AhmedMKAlzoubi/Graduation-Project-Public/Hardware/Components/PB0A/images.jpeg

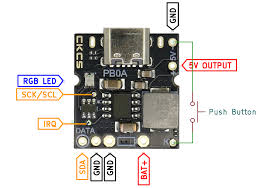
Hardware/Components/PB0A/images.jpeg
