AhmedMKAlzoubi/Graduation-Project-Public/Hardware/Components/PB0A/shopify_pics_23.webp

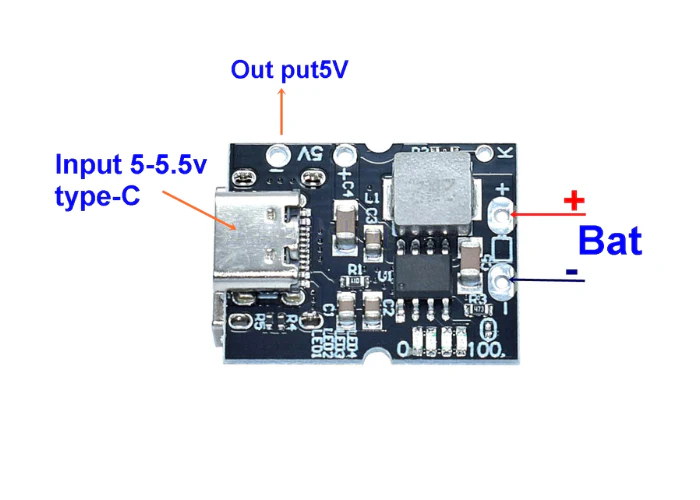
Hardware/Components/PB0A/shopify_pics_23.webp
