AhmedMKAlzoubi/Graduation-Project-Public/README.md

# Smart Helmet with ESP32 and React Capacitor Mobile App

## Overview
This project is a smart helmet system that integrates an ESP32 microcontroller with a React Capacitor mobile application for real-time monitoring and control.

## Features
- ESP32-based helmet control and data collection
- React Capacitor cross-platform mobile app
- Real-time wireless communication
- User-friendly interface

## Tech Stack
- **Backend/Hardware**: ESP32 microcontroller
- **Frontend**: React with Capacitor
- **Communication**: WiFi/Bluetooth

### Hardware Requirements
- ESP32 DevKit-V1
- MPU6050
- TTP223
- PB0A
- ADS115
- Li Polymer 5000mah battery

### Mobile App
Built with React and Capacitor for iOS and Android compatibility.

## Lab Test Video
https://youtube.com/shorts/MDtAqIwwyvM?si=ONj2__RXIM3j2dEX

## License
N/A
