AhmedMKAlzoubi/Graduation-Project-Public/Hardware/Components/MPU6050 Accelerometer/Kicad libarary/MPU-6050.step

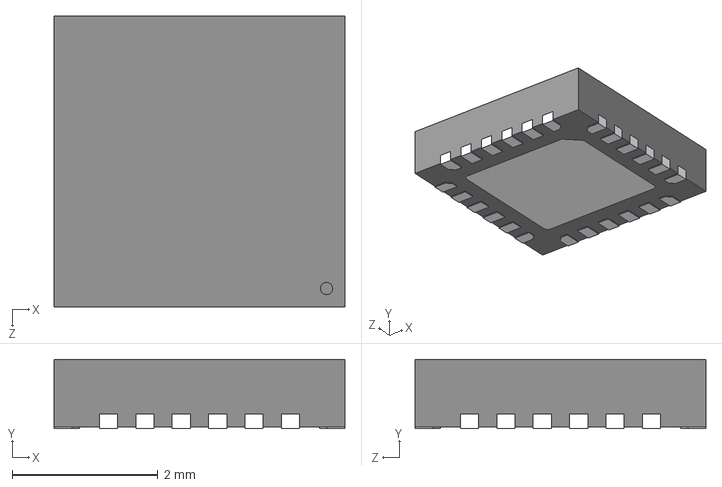
[picture p23: CAD file, 2026-01-06]
Hardware/Components/MPU6050 Accelerometer/Kicad libarary/MPU-6050.step
4.00 x 0.95 x 4.00 mm
