AhmedMKAlzoubi/Graduation-Project-Public/Hardware/Connections/Schematic.kicad_sch

## KiCad design Hardware/Connections/Schematic.kicad_sch (2026-01-06)

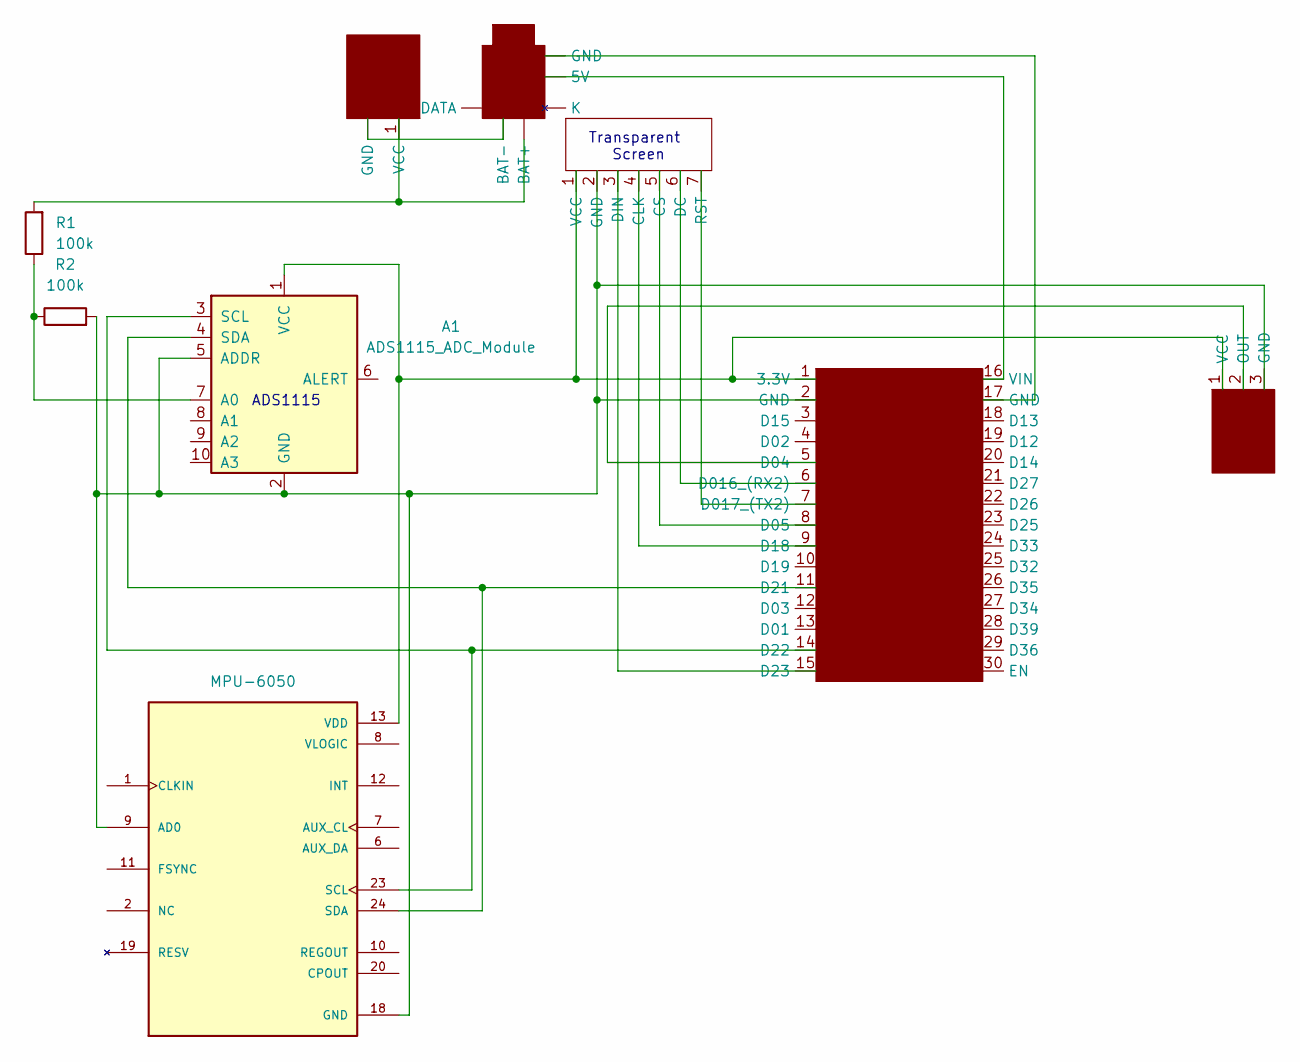
[picture p24: schematic Schematic.kicad_sch]

Parts:
A1: ADS1115_ADC_Module; ADC1115_ADC_Module
R1, R2: 100k
U1: MPU-6050; QFN50P400X400X95-24N; PARTREV 3.4
U2, U3, U5, U6: (no value)
u4: (no value)

Connections:
unnamed: A1.1 (VCC), U1.13 (VDD), U2.1 (VCC), U3.1 (VCC), u4.1 (3.3V)
unnamed: A1.2 (GND), A1.5 (ADDR), R2.2, U1.9 (AD0), U1.18 (GND), U2.3 (GND), U3.2 (GND), u4.2 (GND)
unnamed: A1.3 (SCL), U1.23 (SCL), u4.14 (D22)
unnamed: A1.4 (SDA), U1.24 (SDA), u4.11 (D21)
unnamed: A1.7 (A0), R1.1, R2.1
unnamed: R1.2, U5.1 (VCC)
unnamed: U1.2 (NC), U1.3 (NC), U1.4 (NC), U1.5 (NC), U1.14 (NC), U1.15 (NC), U1.16 (NC), U1.17 (NC)
unnamed: U1.19 (RESV), U1.21 (RESV), U1.22 (RESV)
unnamed: U2.2 (OUT), u4.5 (D04)
unnamed: U3.3 (DIN), u4.15 (D23)
unnamed: U3.4 (CLK), u4.9 (D18)
unnamed: U3.5 (CS), u4.8 (D05)
unnamed: U3.6 (DC), u4.6 (D016_(RX2))
unnamed: U3.7 (RST), u4.7 (D017_(TX2))
unnamed: U5. (GND), U6.
unnamed: U6., u4.16 (VIN), u4.17 (GND)

Notes on the sheet:
Battery
TTP223
USB-C CHARGER WITH BUILT IN VOLT CONVERTER
ESP32-DEVKIT V1
ADS1115
Transparent Screen
